codydalsin/OPI-PCBs/CNEPuckRevF/Project Outputs/Designer Package/DRC/CNEPuckRevF.html

Altium

# Design Rule Verification Report

Date | : | 19/12/2014
Time | : | 7:28:02 AM
Elapsed Time | : | 00:00:05
Filename | : | N:\LloydJ\CNEPuckRevF\CNEPuckRevF.PcbDoc

Warnings | : | 3
Rule Violations | : | 0

## Summary

Warnings | Count
Multilayer Pads with 0 size Hole found | 3
Total | 3

Rule Violations | Count
Power Plane Connect Rule(Direct Connect )(Expansion=20mil) (Conductor Width=10mil) (Air Gap=10mil) (Entries=4) (ISVIA) | 0
Clearance Constraint (Gap=8mil) (All),(All) | 0
Clearance Constraint (Gap=7mil) (InComponent('U13')),(All) | 0
Net Antennae (Tolerance=0mil) (All) | 0
Silk to Silk (Clearance=9mil) (All),(All) | 0
Silk To Solder Mask (Clearance=7mil) (IsPad),(All) | 0
Minimum Solder Mask Sliver (Gap=3mil) (All),(All) | 0
Hole To Hole Clearance (Gap=10mil) (All),(All) | 0
Height Constraint (Min=0mil) (Max=1000mil) (Prefered=500mil) (All) | 0
Hole Size Constraint (Min=1mil) (Max=620mil) (All) | 0
Un-Routed Net Constraint ( (All) ) | 0
Short-Circuit Constraint (Allowed=No) (All),(All) | 0
Power Plane Connect Rule(Relief Connect )(Expansion=20mil) (Conductor Width=20mil) (Air Gap=10mil) (Entries=4) (All) | 0
Width Constraint (Min=8mil) (Max=100mil) (Preferred=8mil) (All) | 0
Clearance Constraint (Gap=4mil) ((InComponent('U16') OR InComponent('U17'))),(All) | 0
Clearance Constraint (Gap=10mil) ((InNamedPolygon('Bottom GND') OR InNamedPolygon('Top GND'))),(All) | 0
Clearance Constraint (Gap=3mil) ((InComponent('RA1') OR InComponent('RA2') OR InComponent('RA3') OR InComponent('RA4'))),(All) | 0
Minimum Solder Mask Sliver (Gap=1.5mil) ((InComponent('RA1') OR InComponent('RA2') OR InComponent('RA3') OR InComponent('RA4'))),(All) | 0
Total | 0

## Warnings

Multilayer Pads with 0 size Hole found

Pad FD1-0(-1842mil,0.001mil) Multi-Layer

Pad FD3-0(0mil,1981.001mil) Multi-Layer

Pad FD2-0(1837mil,0.001mil) Multi-Layer

Back to top
