codydalsin/OPI-PCBs/CableNodeRevG/Project Outputs for CableNodeRevG/BOM/Bill of Materials-CableNodeRevG(Base Variant to Contract Manufacturer).xlsx

Sheet: BOM Report
 | Component list
 | Project: |  | CableNodeRevG.PrjPcb
 | OPI VID:
 | Variant: |  | Base Variant to Contract Manufacturer
 | Design Revision: |  | Rev G
 | Report Date: | 2021-09-09 | 15:46:10
# | Designator | Description | Footprint | Manufacturer 1 | Manufacturer Part Number 1 | Supplier 1 | Supplier Part Number 1 | Manufacturer 2 | Manufacturer Part Number 2 | Supplier 2 | Supplier Part Number 2 | Quantity
1 | BATT1 | 26650 LiFePO4 3.2V 3300mAh | Battery_26650 |  |  |  |  |  |  |  |  | 0
2 | C1 | CAP CER 22PF 50V 5% NPO 0805 | RC0805 | Yageo | CC0805JRNPO9BN220 | Digi-Key | 311-1103-2-ND |  |  |  |  | 1
3 | C2, C3, C4 | CAP CER 4.7UF 6.3V 10% X5R 0805 | RC0805 | Taiyo Yuden | JMK212BJ475KG-T | Digi-Key | 587-1302-2-ND |  |  |  |  | 3
4 | C5, C8 | CAP CER 47UF 10V 20% X5R 1206 | RC1206 | Taiyo Yuden | LMK316BJ476ML-T | Digi-Key | 587-1780-2-ND |  |  |  |  | 2
5 | C6 | CAP CER 10000PF 100V X7R 0805 | RC0805 | TDK | C2012X7R2A103K085AA | Digi-Key | 445-1343-2-ND |  |  |  |  | 1
6 | C7, C50, C54 | CAP CER 10000PF 50V 10% X7R 0603 | RC0603 | TDK | C1608X7R1H103K080AA | Digi-Key | 445-1311-2-ND |  |  |  |  | 3
7 | C9, C10, C11, C20, C51, C53 | CAP CERM .1UF 10% 16V X7R 0603 | RC0603 | Kyocera AVX | 0603YC104KAT2A\4K | Digi-Key | 478-1239-2-ND |  |  |  |  | 6
8 | C52 | CAP CERM .1UF 10% 16V X7R 0603 | RC0603 | Kyocera AVX | 0603YC104KAT2A\4K | Digi-Key | 478-1239-2-ND |  |  |  |  | 0
9 | CANADAFLAG1, CANADAFLAG2 | Canada Flag | CanadaFlag500x250 |  |  |  |  |  |  |  |  | 0
10 | D1, D4 | DIODE SCHOTTKY 1A 200V PWRDI 123 | POWERDI-123 | Diodes | DFLU1200-7 | Arrow Electronics | DFLU1200-7 | Diodes | DFLS12007 | Digi-Key | DFLS1200DITR-ND | 2
11 | D2, D5, D10 | SUPPRESSOR ESD 24VDC 0603 SMD | RC0603 | Littelfuse | PGB1010603NR | Digi-Key | F3591TR-ND |  |  |  |  | 3
12 | D3, D11, D12, D13, D14 | DIODE SW DUAL 75V 350MW SOT23-3 | SOT23 | Diodes | BAV99-7-F | Digi-Key | BAV99-FDITR-ND |  |  |  |  | 5
13 | D6, D8, D9 | TVS BIDIRECT 50W SOD523 | SOD-523 | ON Semiconductor | ESD5B5.0ST1G | Digi-Key | ESD5B5.0ST1GOSTR-ND |  |  |  |  | 3
14 | D15 | DIODE ZENER 5.42V 500MW SOD323F | SOD323F | Diodes | DDZ5V6ASF-7 | Digi-Key | DDZ5V6ASF-7DITR-ND |  |  |  |  | 1
15 | D16 | DIODE SCHOTTKY 40V 30MA SOT323 | SOT-323 | Diodes | SDMG0340LC-7-F | Digi-Key | SDMG0340LC-FDITR-ND |  |  |  |  | 1
16 | F1 | POLYSWITCH 2.6A RESET FUSE SMD | MINISMDC260F | TE Connectivity | MINISMDC260F-2 | Avnet | MINISMDC260F-2 |  |  |  |  | 1
17 | F2, F3 | POLYSWITCH .50A RESET FUSE SMD | MINISMD050 | Littelfuse | MINISMDC050F-2 | Arrow Electronics | MINISMDC050F-2 |  |  |  |  | 2
18 | FD1, FD2, FD3 | Fiducial Round | FIDUCIAL ROUND SMALL |  |  |  |  |  |  |  |  | 0
19 | J1 | CONN HEADER 2POS 3MM VERT GOLD | BATTERYCONNECTOR | Molex | 43650-0215 | Digi-Key | WM1917-ND |  |  |  |  | 1
20 | L1 | INDUCTOR POWER 3.6UH 1.38A SMD | IND-WURTH | Wurth Electronics | 744031003 | Digi-Key | 732-1007-2-ND |  |  |  |  | 1
21 | L2 | INDUCTOR PWR 22UH 20% SHIELD SMD | IND-SRR0604 | Bourns | SRR0604-220ML | Digi-Key | SRR0604-220MLTR-ND |  |  |  |  | 1
22 | LED1, LED4 | LED | GHJTLPS124K5L211150R33 | Osram Opto | GHJTLPS1.24-K5L2-1-1-150-R33 | Mouser | 720-GHJTLPS124A1048 |  |  |  |  | 2
23 | LED2, LED3 | LED | GHJTLPS124K5L211150R33 | Osram Opto | GDJTLPS1.14-MFN8-25-1-150-R33 | Mouser | 720-GDJTLPS114A1051 |  |  |  |  | 2
24 | MH1, MH2, MH3 | PCB Mounting Hole, 0.150" hole, 0.270" Keepout | MountingHole |  |  |  |  |  |  |  |  | 0
25 | P1 | SIL HORIZ PC TAIL PIN HEADER | HDR1X2 | Harwin | M20-9960245 | Digi-Key | 952-2244-ND |  |  |  |  | 1
26 | P2 | Header, 4-Pin | HDR1X4 |  |  |  |  |  |  |  |  | 0
27 | P3 | Header, 2-Pin | HDR1X2 |  |  |  |  |  |  |  |  | 0
28 | P4 | CONN EDGECARD 6POS .100 FINGERS | EdgeConnectorFingers |  |  |  |  |  |  |  |  | 0
29 | P5 | CONN HEADER RT ANG 3POS 5.08MM | PC-1759020 | Phoenix Contact | 1759020 | Digi-Key | 277-1096-ND |  |  |  |  | 1
30 | P6, P7 | CONN SOCKET 12POS 2MM VERT T/H | HEADER1X12-2MM | Adam Equipment | 2RS1-12-G | Digi-Key | 2057-2RS1-12-G-ND | 3M | 950512-6102-AR | Digi-Key | 3M9406-ND | 2
31 | Q1 | MOSFET P-CH 20V 2.2A SOT23-3 | SOT23(DGS) | Vishay | SI2301BDS-T1-E3 | Digi-Key | SI2301BDS-T1-E3TR-ND |  |  |  |  | 1
32 | Q2, Q3, Q4, Q5 | MOSFET N-CH 20V 2.6A SOT23-3 | SOT23 | Vishay Siliconix | SI2302CDS-T1-GE3 | Digi-Key | SI2302CDS-T1-GE3TR-ND |  |  |  |  | 4
33 | Q6 | IC SWITCH P-CHANNEL SOT-23 | SOT23 | ON Semiconductor / Fairchild | MMBFJ270 | Digi-Key | MMBFJ270TR-ND |  |  |  |  | 1
34 | R1 | RES 3.24M OHM 1/8W 1% 0805 SMD | RC0805 | Vishay | CRCW08053M24FKEA | Digi-Key | 541-3.24MCTR-ND |  |  |  |  | 1
35 | R2, R6, R9 | RES 3.83M OHM 1/10W 1% 0603 SMD | RC0603 | Vishay | CRCW06033M83FKEA | Digi-Key | 541-3.83MHTR-ND |  |  |  |  | 3
36 | R3 | RES 1.02M OHM 1/8W 1% 0805 SMD | RC0805 | Vishay | CRCW08051M02FKEA | Digi-Key | 541-1.02MCTR-ND |  |  |  |  | 1
37 | R4, R10 | RES 7.50M OHM 1/10W 1% 0603 SMD | RC0603 | Vishay | CRCW06037M50FKEA | Digi-Key | 541-7.50MHTR-ND |  |  |  |  | 2
38 | R5 | RES 2.00M OHM 1/10W 1% 0603 SMD | RC0603 | Vishay | CRCW06032M00FKEA | Digi-Key | 541-2.00MHCT-ND |  |  |  |  | 1
39 | R7 | RES 4.22M OHM 1/10W 1% 0603 SMD | RC0603 | Vishay | CRCW06034M22FKEA | Digi-Key | 541-4.22MHTR-ND |  |  |  |  | 1
40 | R8 | RES 4.75M OHM 1/10W 1% 0603 SMD | rc0603 | Vishay | CRCW06034M75FKEA | Digi-Key | 541-4.75MHTR-ND |  |  |  |  | 1
41 | R11 | RES 4.99M OHM 1/10W 1% 0603 SMD | rc0603 | Vishay | CRCW06034M99FKEA | Digi-Key | 541-4.99MHTR-ND |  |  |  |  | 1
42 | R12 | RES 5.36M OHM 1/10W 1% 0603 SMD | RC0603 | Vishay | CRCW06035M36FKEA | Digi-Key | 541-5.36MHTR-ND |  |  |  |  | 1
43 | R13 | RES 1.0M OHM 1/10W 5% 0603 SMD | RESC1608X06N | Panasonic | ERJ-3GEYJ105V | Digi-Key | P1.0MGDKR-ND |  |  |  |  | 1
44 | R15 | RES 27.0 OHM 1/10W 1% 0603 SMD | RC0603 | Panasonic | ERJ-3EKF27R0V | Digi-Key | P27.0HTR-ND |  |  |  |  | 1
45 | R16, R20, R23, R24, R31, R34, R44, R51, R52, R53, R63, R69 | RES 10K OHM 1/10W 5% 0603 SMD | RC0603 | Panasonic | ERJ-3GEYJ103V | Digi-Key | P10KGTR-ND |  |  |  |  | 12
46 | R17 | RES 51.1 OHM 1/2W 1% 1210 SMD | RC3225X07N | Panasonic | ERJ-14NF51R1U | Digi-Key | P51.1AATR-ND |  |  |  |  | 1
47 | R18 | RES 24 OHM 1W 5% 2512 SMD | RES2512 | Stackpole Electronics | RMCF2512JT24R0 | Digi-Key | RMCF2512JT24R0TR-ND |  |  |  |  | 1
48 | R19, R67 | RES 100K OHM 1/10W 5% 0603 SMD | RC0603 | Panasonic | ERJ-3GEYJ104V | Digi-Key | P100KGTR-ND |  |  |  |  | 2
49 | R21, R32 | RES 22.0 OHM 1/4W 1% 1206 SMD | RC1206 | Yageo | RC1206FR-0722RL | Digi-Key | 311-22.0FRTR-ND |  |  |  |  | 2
50 | R22, R29, R42, R43 | RES 12.0 OHM 1/4W 1% 1206 SMD | RC1206 | Yageo | RC1206FR-0712RL | Digi-Key | 311-12.0FRTR-ND |  |  |  |  | 4
51 | R25, R26, R30, R33, R62 | RES 1.0K OHM 1/10W 5% 0603 SMD | rc0603 | Panasonic | ERJ-3GEYJ102V | Digi-Key | P1.0KGTR-ND |  |  |  |  | 5
52 | R27, R28, R40, R41, R47, R60, R66 | RES 100 OHM 1/10W 5% 0603 SMD | RC0603 | Panasonic | ERJ-3GEYJ101V | Digi-Key | P100GCT-ND |  |  |  |  | 7
53 | R35, R36 | RES 1.00M OHM 1/10W 1% 0603 SMD | rc0603 | Panasonic | ERJ-3EKF1004V | Digi-Key | P1.00MHTR-ND |  |  |  |  | 2
54 | R37, R65 | RES 715K OHM 1/10W 1% 0603 SMD | RC0603 | Panasonic | ERJ-3EKF7153V | Digi-Key | P715KHTR-ND |  |  |  |  | 2
55 | R38 | RES 432K OHM 1/10W 1% 0603 SMD | RC0603 | Panasonic | ERJ-3EKF4323V | Digi-Key | P432KHTR-ND |  |  |  |  | 1
56 | R39 | RES 330 OHM 1/8W 5% 0805 SMD | RC0805 | Panasonic | ERJ-6GEYJ331V | Digi-Key | P330ATR-ND |  |  |  |  | 1
57 | R45 | RES 12 OHM 1W 5% 2512 | RES2512 | Stackpole Electronics | RPC2512JT12R0 | Digi-Key | RPC2512JT12R0TR-ND |  |  |  |  | 1
58 | R46 | RES 0.0 OHM 1/10W 0603 SMD | RC0603 | Panasonic | ERJ-3GEY0R00V | Digi-Key | P0.0GTR-ND |  |  |  |  | 0
59 | R50 | RES 10K OHM 1/10W 5% 0603 SMD | RC0603 | Panasonic | ERJ-3GEYJ103V | Digi-Key | P10KGTR-ND |  |  |  |  | 0
60 | R54 | RES 2K OHM 1/10W 1% 0603 SMD | RC0603 | Panasonic | ERJ-3EKF2001V | Digi-Key | P2.00KHTR-ND |  |  |  |  | 1
61 | R55, R56, R57, R68 | RES 4.7K OHM 1/10W 5% 0603 SMD | RC0603 | Panasonic | ERJ-3GEYJ472V | Digi-Key | P4.7KGTR-ND |  |  |  |  | 4
62 | R58 | RES 200K OHM 1/10W 5% 0603 SMD | RC0603 | Panasonic | ERJ-3GEYJ104V | Digi-Key | P100KGTR-ND |  |  |  |  | 1
63 | R64 | RES 3M65 OHM 1/10W 1% 0603 SMD | RC0603 | Vishay | CRCW06033M65FKEA | Digi-Key | 541-3.65MHCT-ND | Vishay Dale | CRCW06033M65FKTA | Mouser | 71-CRCW06033654FT | 1
64 | RAD1 | Synapse RF200PF1 Snappy Transceiver | RF200 |  |  |  |  |  |  |  |  | 0
65 | SP1 | Solar Panel, Flexible, 3.6V and 4.8V footprints | SOLAR_PANEL_FLEX |  |  |  |  |  |  |  |  | 0
66 | SW1 | SWITCH REED MAG SMT 25-30 AT | MK15-E-2 | Standex-Meder Electronics | MK15-E-2 | Digi-Key | 374-1303-1-ND |  |  |  |  | 1
67 | TP1, TP2, TP3, TP4, TP5, TP6, TP7, TP8, TP9, TP10, TP11, TP12, TP13, TP14, TP15, TP16, TP17, TP18, TP19, TP20, TP21, TP22, TP23, TP24 |  | TestPoint |  |  |  |  |  |  |  |  | 0
68 | U1 | IC REG BOOST SYNC ADJ 0.55A 6DFN | LTC3526 | Analog Devices / Linear Technology | LTC3526LBEDC-2#TRMPBF | Digi-Key | LTC3526LBEDC-2#TRMPBFTR-ND |  |  |  |  | 1
69 | U2 | IC ENERGY HARV CTRLR BATT 16QFN | BQ25504 | Texas Instruments | BQ25504RGTT | Digi-Key | 296-29741-2-ND |  |  |  |  | 1
70 | U3, U5 | IC LOAD SWITCH INTEGRATED SC70-6 | TS5A3160 | ON Semiconductor | NTJD1155LT1G | Newark | 71J7047 | ON Semiconductor / Fairchild | FDG6342L | Digi-Key | FDG6342LTR-ND | 2
71 | U6 | IC BRIDGE I2C TO 1-WIRE 8-SOIC | SOIC127P580X153-8N | Maxim | DS2482S-100+ | Digi-Key | DS2482S-100+-ND |  |  |  |  | 1
72 | U8, U9 | IC SWITCH SPDT SC88 | TS5A3160 | ON Semiconductor | NLAS4157DFT2G | Digi-Key | NLAS4157DFT2GOSTR-ND |  |  |  |  | 2
73 | U10 | IC LEVEL TRANSLATOR - TSSOP8 | TSOP65P640X120-8N | ON Semiconductor | PCA9306DTR2G | Digi-Key | PCA9306DTR2GOSCT-ND |  |  |  |  | 1
74 | U11 | Low Quiescent Current, Programmable-Delay Supervisory Circuit | SOT95P270X145-6N | Texas Instruments | TPS3808G01DBVR | Digi-Key | 296-17188-1-ND |  |  |  |  | 1
Approved |  | Notes

Sheet: Project Information
Project Full Path | C:\Users\CodyD\Documents\GitHub\OPI-PCBs\CableNodeRevG\CableNodeRevG.PrjPcb
Project Filename | CableNodeRevG.PrjPcb
Variant Name | Base Variant to Contract Manufacturer
Data-Source Filename | CableNodeRevG.BomDoc
Data-Source Full Path | C:\Users\CodyD\Documents\GitHub\OPI-PCBs\CableNodeRevG\CableNodeRevG.BomDoc
Title | Bill of Materials for Variant [Base Variant to Contract Manufacturer] of BOM Document [CableNodeRevG.BomDoc]
Total Quantity | 123
Report Time | 3:45 PM
Report Date | 2021-09-09
Report Date & Tine | 2021-09-09 3:45 PM
Output Name | Bill of Materials
Output Type | BomReport
Output Generator Name | BOM
Output Generator Description | Bill of Materials
