codydalsin/OPI-PCBs/CableNodeRevG/CableNodeRevG.step

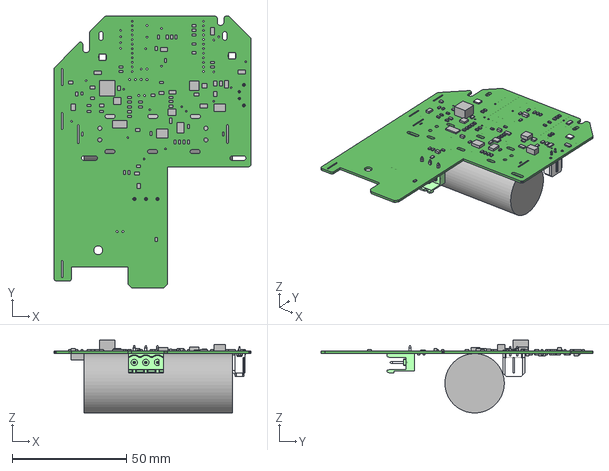
[picture p1: CAD file, 2021-09-10]
CableNodeRevG/CableNodeRevG.step
86.2 x 118.9 x 31.9 mm
