codydalsin/OPI-PCBs/(list of files, cad)

Other CAD files:
CableNodeRevG/CableNodeRevG.x_t
