codydalsin/OPI-PCBs/(list of files, drawings)

Other design files:
CableNodeRevG/CableNodeRevG.PrjPcb
CableNodeRevG/CableNodeRevG.SchDoc
CableNodeRevG/Swage.SchLib
CNEPuckRevF/CNEPuckCPURevF.SchDoc
CNEPuckRevF/CNEPuckRevF.PcbDoc
CNEPuckRevF/CNEPuckRevF.PrjPcb
CNEPuckRevF/CNEPuckRevF_Drivers_1.SchDoc
CNEPuckRevF/CNEPuckRevF_Drivers_2.SchDoc
CNEPuckRevF/Swage.SchLib
CNEPuckRevG/CNEPuckCPURevG.SchDoc
CNEPuckRevG/CNEPuckRevG.PrjPcb
CNEPuckRevG/CNEPuckRevG_Drivers_1.SchDoc
CNEPuckRevG/CNEPuckRevG_Drivers_2.SchDoc
CNEPuckRevG/Swage.SchLib
EVO-PCB/EVO Library.PcbLib
EVO-PCB/EVO SCH LIB.SchLib
EVO-PCB/EVO Schematic.SchDoc
EVO-PCB/EVO-PCB-R.PrjPcb
EVO-PCB/EVO-PCB.PrjPcb
EVO-PCB/PCB Main.PcbDoc
EVO-PCB/PCB Radio.PcbDoc
EVO-PCB/temp.SchDoc
