codydalsin/OPI-PCBs/(commit log)

2021-09-07 Added CableNodeRevG to repo
    [Bill of Materials-CableNodeRevF(Base Variant to Contract Manufacturer).xls, Bill of Materials-CableNodeRevF(Base Variant to Contract Manufacturer).xlsm, CableNodeRevF(Base Variant to Contract Manufacturer).step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]
2021-09-10 Added CableNodeRevG and CNE REVG
    CableNodeRevG to go to mfgt for first article of new design which incorporates a new LED style, and new foot print for the LED.
    CNE Rev G is WIP
    [Bill of Materials -Cable Node REV G.xlsx, Bill of Materials -Cable Node REV Gold.xlsx, Bill of Materials-CableNodeRevF(Base Variant to Contract Manufacturer).xls, Bill of Materials-CableNodeRevF(Base Variant to Contract Manufacturer).xlsm, Bill of Materials-CableNodeRevG(Base Variant to Contract Manufacturer).xlsx, BoM_CNE-CNEPuckRevF(Variant to Contract Manufacturer).xls, CNEPuckCPURevF.SchDoc, 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]
